Gui-arain/Flight-Controller/docs/README.md

<!--
This project follows atomic documentation.
Each subsystem is documented independently.
All configs are stored in YAML.
This directory is optimized for LLMs.
-->

# Flight Controller Documentation

This documentation describes the hardware, power, MCU, sensor suite, and communication interfaces.
