Gui-arain/Flight-Controller/docs/hardware/stm32-subsystem/imgs/analog-power-filter.png

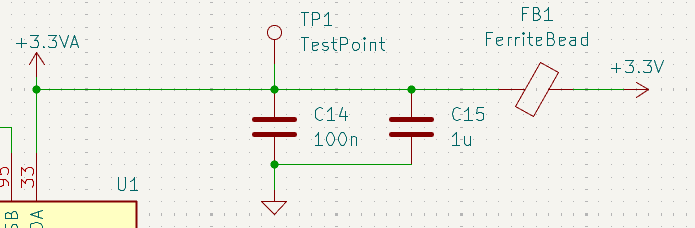
docs/hardware/stm32-subsystem/imgs/analog-power-filter.png
