Gui-arain/Flight-Controller/docs/hardware/stm32-subsystem/imgs/vref-filter.png

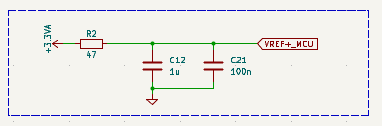
docs/hardware/stm32-subsystem/imgs/vref-filter.png
