Gui-arain/Flight-Controller/exports/imgs/Capture d’écran 2026-05-28 à 21.54.42.png

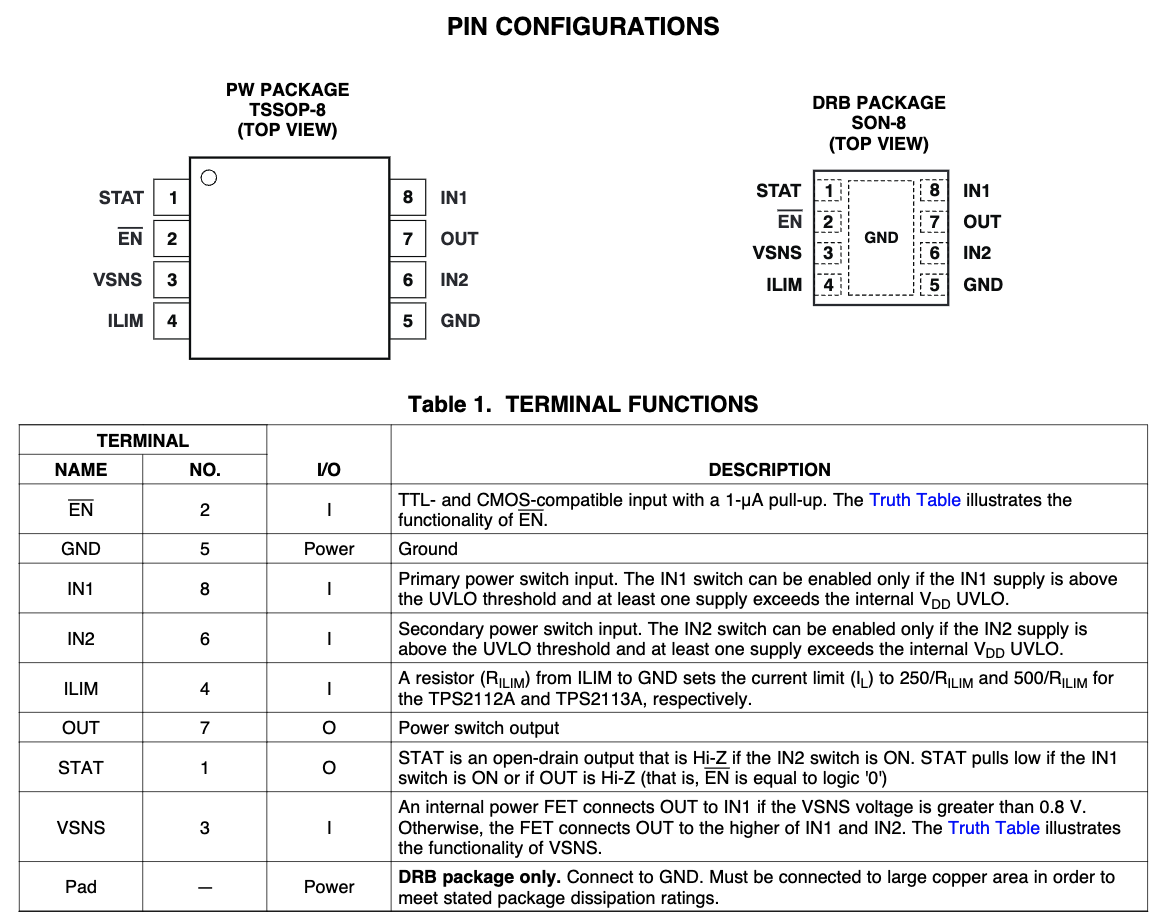
exports/imgs/Capture d’écran 2026-05-28 à 21.54.42.png
