Gui-arain/Flight-Controller/hardware/Component-Library.xlsx

Sheet: ICs
Category | Component | Description |  |  | Boards |  | Suppliers
 |  | Package | Datasheet | Comment | proto v1.0 | v2.0 | JLCPCB | DigiKey
SENSOR
IMU | ICM-42688-P |  | ..\resources\datasheets\IMU\ds-000347_icm-42688-p-datasheet.pdf | best noise / ODR 32kHz | yes | yes
 | BMI088 |  | ..\resources\datasheets\IMU\bst-bmi088-ds001.pdf | Best reliability max acc 24g | no | yes
 | ICM-40609-D |  |  | ODR 32kHz max 32g | no | yes
MAG | MMC5983MA |  | ..\resources\datasheets\MAG\MMC5983MADatasheetRevA.pdf | best heading | yes | yes
 | BMM350 |  | ..\resources\datasheets\MAG\bst-bmm350-ds001.pdf | reliable | no | ?
BAR | MS5611-01BA03 |  | ..\resources\datasheets\BAR\ENG_DS_MS5611-01BA03_B3.pdf |  | no | yes
 | BMP390 |  | ..\resources\datasheets\BAR\bst-bmp390-ds002.pdf |  | yes | yes
COMPUTING
MCU | STM32H743ZIT6 | LQFP-144 | ..\resources\datasheets\STM32\Datasheet\STM32H743xI-G.pdf |  | yes | no | STM32H743ZIT6 (https://jlcpcb.com/partdetail/STMicroelectronics-STM32H743ZIT6/C114408)
 | STM32H753 |  |  |  | yes | no
 | STM32H757 |  |  | dual core | yes | no
POWER
MUX | TPS2113A | 8-VDFN Exposed Pad (3x3) | ..\resources\datasheets\POWER\TPS2113a.pdf | 5V Mux 2A max | yes | no |  | DigiJey-TPS2113A (https://www.digikey.com.au/en/products/detail/texas-instruments/TPS2113ADRBR/2353703)
BUCK | TPS62130ARGTR | 16-VFQFN Exposed Pad (https://www.digikey.com.au/en/products/filter/power-management-pmic/voltage-regulators-dc-dc-switching-regulators/16-vfqfn-exposed-pad/739) | ..\resources\datasheets\POWER\TPS62130.pdf |  | yes | no |  | DigiKey-TPS62130 (https://www.digikey.com.au/en/products/detail/texas-instruments/TPS62130ARGTR/4307640)
TRANSCEIVER
CAN | MCP2562FD-E/SN | 8-SOIC (0.154", 3.90mm Width) | ..\resources\datasheets\CAN\MCP2561-2FD-datasheet.pdf | convert CAN TX/RX to H/L | yes |  | JLCPCB-MCP2562FD (https://jlcpcb.com/partdetail/MicrochipTech-MCP2562FD_ESN/C124016) | DigiKey-MCP2562FD (https://www.digikey.com.au/en/products/detail/microchip-technology/MCP2562FD-E-SN/4842808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)
 | MCP2562FDT-E/MF | 8-VDFN Exposed Pad |  |  | no |  |  | DijiKey-MPC2562FDF (https://www.digikey.com.au/en/products/detail/microchip-technology/MCP2562FDT-E-MF/4860104)

Sheet: Standard components
Category | Component | Description |  |  | Boards |  | Suppliers
 |  | Package | Datasheet | Comment | proto v1.0 | v2.0 | JLCPCB | DigiKey
LED | 19-337C/RSBHGHC-A88/4T | 0606 (1616 Metric) | ..\resources\datasheets\LED\Everlight 19-337C.pdf | RGB LED | yes | yes |  | DigiKey-19-337C (https://www.digikey.com.au/en/products/detail/everlight-electronics-co-ltd/19-337C-RSBHGHC-A88-4T/10059590)
 | LTST-C150EKT | 1206 (3216 Metric) | ..\resources\datasheets\LED\LTST-C150EKT.pdf | Red LED | yes | no |  | DigiKey-LTST-C150EKT (https://www.digikey.com.au/en/products/detail/liteon/LTST-C150EKT/269215)
 | LTST-C150GKT | 1206 (3216 Metric) | ..\resources\datasheets\LED\LTST-C150GKT.pdf | Green LED | yes | no | JLCPCB-LTST-C150EKT (https://jlcpcb.com/partdetail/LiteOn-LTSTC150GKT/C125084) | DigiKey-LTST-C150GKT (https://www.digikey.com.au/en/products/detail/liteon/LTST-C150GKT/269216)
 | LTST-C191KGKT | 0603 (1608 Metric) | ..\resources\datasheets\LED\LTST-C191KGKT.PDF | Green LED | no | yes |  | DigiKey-LTST-C161KGKT (https://www.digikey.com.au/en/products/detail/liteon/LTST-C191KGKT/386835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)
CRYSTAL | TSX-3225 16.0000MF18X-AC3 | 4-SMD (3.2x2.5) | ..\resources\datasheets\CRYSTAL\TSX-3225_en.pdf | 16MHz 9pF 60Ohms | yes |  | JLCPCB-TSX-3225 (https://jlcpcb.com/partdetail/2078519-TSX_3225_16_0000MF18XAC3/C1986974) | DigiKey-TSX3225 (https://www.digikey.com.au/en/products/detail/epson/TSX-3225-16-0000MF18X-AC3/1825445)
SWITCH | PCM12SMTR |  | ..\resources\datasheets\SWITCH\C221841.pdf | 6V | yes |  | JLCPCB-PCM12SMTR (https://jlcpcb.com/partdetail/CK-PCM12SMTR/C221841) | DigiKey-PCM12SMTR (https://www.digikey.com.au/en/products/detail/c-k/PCM12SMTR/1640112)
 | CUS-12TB |  | ..\resources\datasheets\SWITCH\CUS-12TB.pdf | 4V | no |  | JLCPCB-CUS-12TB (https://jlcpcb.com/partdetail/Nidec-CUS12TB/C2921739) | DigiKey-CUS-12TB (https://www.digikey.com.au/en/products/detail/nidec-components-corporation/CUS-12TB/1124222)
CAP | CL05B104KO5NNNC | 0402 (1005 Metric) |  | 100nF MLCC | yes |  | JLCPCB-MLCC100nF (https://jlcpcb.com/partdetail/1877-CL05B104KO5NNNC/C1525)
 |  | 0603 |  | MLCC | no
 |  | 0805 |  | MLCC | no
 |  | 0402 |  | Tantalum | no
 |  | 0603 |  | Tantalum | no
 |  | 0805 |  | Tantalum | no
ESD | TPD4E05U06DQAR | 10-UFDFN (2.5x1) | ..\resources\datasheets\ESD\tpd4e05u06.pdf | TVS DIODE 5.5VWM 14VC 10USON | yes |  | JLCPCB-TPD4E05 (https://jlcpcb.com/partdetail/TexasInstruments-TPD4E05U06DQAR/C138714) | DigiKey-TPD4E05 (https://www.digikey.com/en/products/detail/texas-instruments/TPD4E05U06DQAR/3996774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)
 | TSD05DYFR | SC-76, SOD-323 | ..\resources\datasheets\ESD\tsd05.pdf | TVS DIODE 5.5VWM 9VC SOD-323 | yes |  | JLCPCB-TSD05 (https://jlcpcb.com/partdetail/TexasInstruments-TSD05DYFR/C22396185) | DigiKey-TSD05 (https://www.digikey.com/en/products/detail/texas-instruments/TSD05DYFR/21298352)
FUSE | MF-MSMF050-2 | 1812 (4532 Metric), Concave | ..\resources\datasheets\FUSE\mf-msmf.pdf | Polymeric PTC Resettable Fuse 15V 500 mA | yes |  | JLCPCB-MF-MSMF050 (https://jlcpcb.com/partdetail/BOURNS-MF_MSMF0502/C17313) | DigiKey-MF-MSMF050 (https://www.digikey.com.au/en/products/detail/bourns-inc/MF-MSMF050-2/662816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)
MOSFET | 2N7002 | SOT-23-3 (TO-236) | ..\resources\datasheets\MOSFET\Diotec-2n7002.pdf | MOSFET N-CH 60V 280MA | no |  |  | DigiKey-2N7002 (https://www.digikey.com.au/en/products/detail/diotec-semiconductor/2N7002/13163336)
 | AO3400A | 3-SMD, SOT-23-3 Variant (https://www.digikey.com.au/en/products/filter/transistors/fets-mosfets/single-fets-mosfets/3-smd-sot-23-3-variant/278) | ..\resources\datasheets\MOSFET\AO3400A_ds.pdf | N-Channel 30 V 5.7A (Ta) 1.4W (Ta | yes |  | JLCPCB-AO3400A (https://jlcpcb.com/partdetail/Alpha_OmegaSemicon-AO3400A/C20917) | DigiKey-AO3400A (https://www.digikey.com.au/en/products/detail/alpha-omega-semiconductor-inc/AO3400A/1855772)

Sheet: Interfaces
Category | Component | Description |  |  | Boards |  | Suppliers
 |  | Package | Datasheet | Comment | proto v1.0 | v2.0 | JLCPCB | DigiKey
MEM | MEM2061 |  | ..\resources\datasheets\SD_CARD\mem2061-spec.pdf | micro SD card socket | yes | yes |  | DigiKey-MEM2061 (https://www.digikey.com.au/en/products/detail/gct/MEM2061-01-188-00-A/9859612)
USB-C | USB4105 |  | ..\resources\datasheets\USB-C\usb4105-spec.pdf |  | yes | yes
CONNECTOR | SM04B-GHS-TB |  | ..\resources\datasheets\CONNECTOR\GH1.25-datasheet.pdf | GH1,25 4 pins | yes |  |  | DigiKey-SM04B-GHS (https://www.digikey.com.au/en/products/detail/jst-sales-america-inc/SM04B-GHS-TB/807788)
 | SM03B-GHS-TB |  | ..\resources\datasheets\CONNECTOR\GH1.25-datasheet.pdf | GH1,26 3pins | yes |  |  | DigiKey-SM03B-GHS (https://www.digikey.com.au/en/products/detail/jst-sales-america-inc/SM03B-GHS-TB/807787)
 | SM06B-GHS-TB |  | ..\resources\datasheets\CONNECTOR\GH1.25-datasheet.pdf | GH1,26 6pins | yes |  |  | DigiKey-SM6B-GHS (https://www.digikey.com.au/en/products/detail/jst-sales-america-inc/SM06B-GHS-TB/807790)
 | FTSH-105-01-F-DV-K |  |  | 10 pin 1,27 for Cortex-M Debug | yes |  | JLCPCB-FTSH-105 (https://jlcpcb.com/partdetail/Samtec-FTSH_105_01_L_DVK/C5155080) | DigiKey-FTSH-105 (https://www.digikey.com.au/en/products/detail/samtec-inc/FTSH-105-01-F-DV-K/2649974)
