Gui-arain/Flight-Controller/hardware/cad-layout/19-337C/19-337C_RSBHGHC-A88_4T.STEP

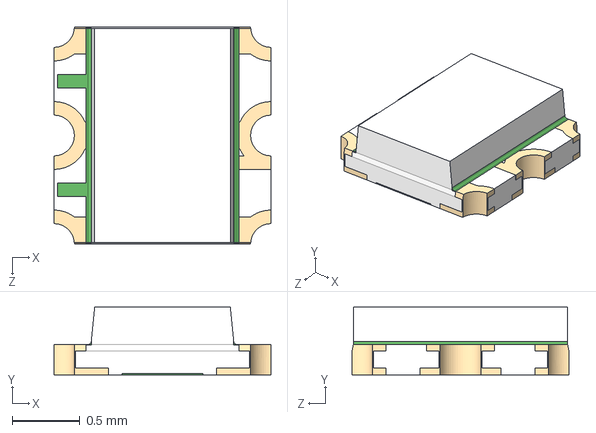
[picture p5: CAD file, 2025-11-23]
hardware/cad-layout/19-337C/19-337C_RSBHGHC-A88_4T.STEP
1.60 x 0.5 x 1.60 mm
