Gui-arain/Flight-Controller/hardware/cad-layout/BMP390/10LGA_2X2X0p75_BOS.step

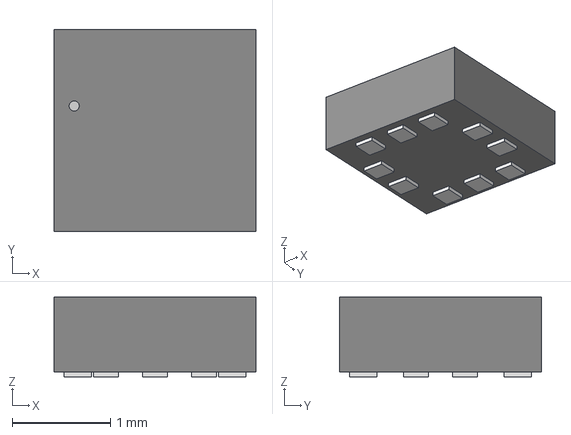
[picture p6: CAD file, 2025-11-23]
hardware/cad-layout/BMP390/10LGA_2X2X0p75_BOS.step
2.06 x 2.06 x 0.815 mm
