Gui-arain/Flight-Controller/hardware/cad-layout/FTSH-105-01-F-DV-K/FTSH-105-01-F-DV-K.stp

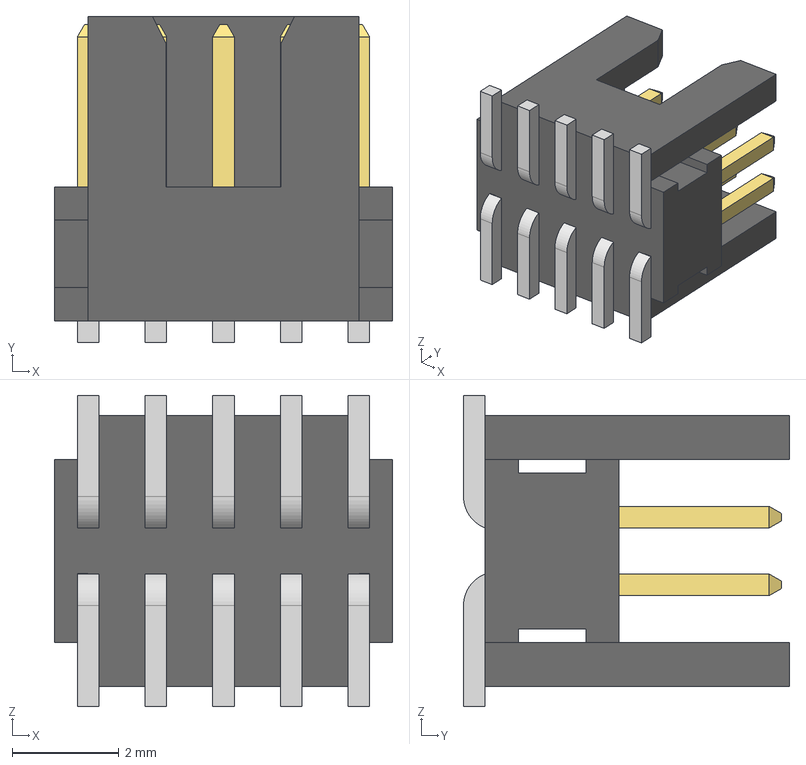
[picture p7: CAD file, 2025-11-23]
hardware/cad-layout/FTSH-105-01-F-DV-K/FTSH-105-01-F-DV-K.stp
6.35 x 6.12 x 5.84 mm
FTSH-105-01-F-DV-K_body
FTSH-105-01-F-DV-K_pins1
FTSH-105-01-F-DV-K_pins2
