Gui-arain/Flight-Controller/hardware/cad-layout/ICM-42688-P/LGA14_2P5X3X0P91_TDK.step

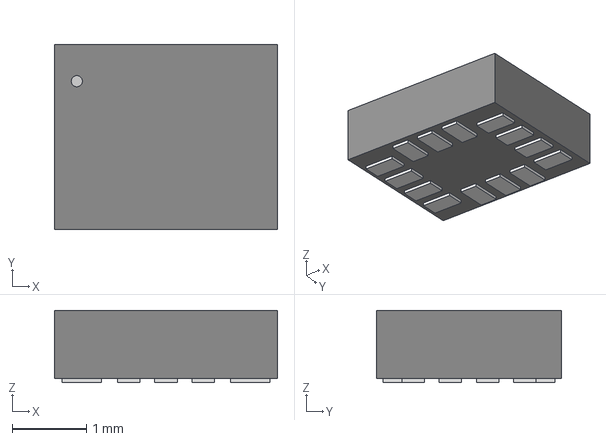
[picture p8: CAD file, 2025-11-23]
hardware/cad-layout/ICM-42688-P/LGA14_2P5X3X0P91_TDK.step
3.00 x 2.49 x 0.968 mm
