Gui-arain/Flight-Controller/hardware/cad-layout/LTST-C150GKT/LTST-C150GKT.STEP

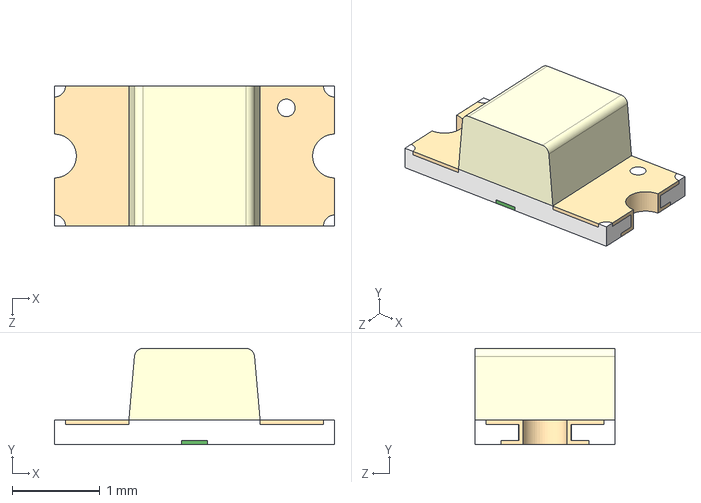
[picture p9: CAD file, 2025-11-23]
hardware/cad-layout/LTST-C150GKT/LTST-C150GKT.STEP
3.20 x 1.10 x 1.60 mm
