Gui-arain/Flight-Controller/hardware/cad-layout/MCP2562FD-E-SN/SOIC8-N_MC_MCH.step

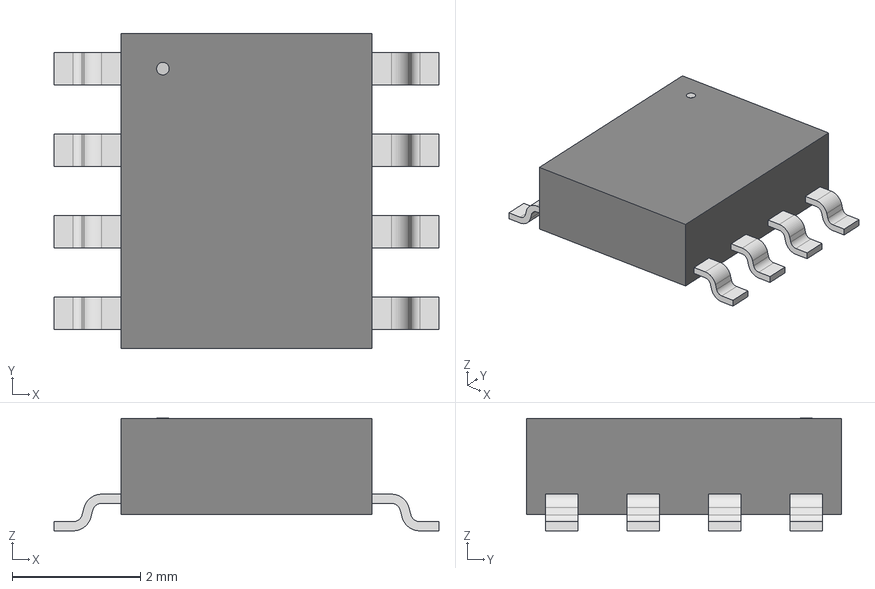
[picture p10: CAD file, 2025-11-23]
hardware/cad-layout/MCP2562FD-E-SN/SOIC8-N_MC_MCH.step
5.99 x 4.90 x 1.75 mm
