Gui-arain/Flight-Controller/hardware/cad-layout/MMC5983MA/MMC5983MA_MEM.step

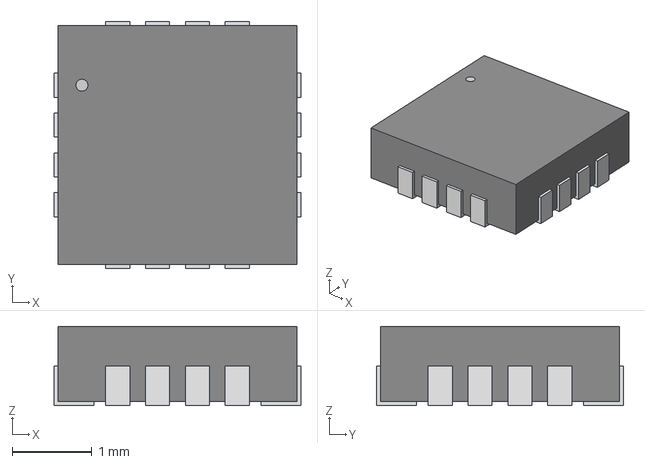
[picture p11: CAD file, 2025-11-23]
hardware/cad-layout/MMC5983MA/MMC5983MA_MEM.step
3.10 x 3.10 x 0.993 mm
