Gui-arain/Flight-Controller/hardware/cad-layout/SM03B-GHS-TB/SM03B-GHS-TB.STEP

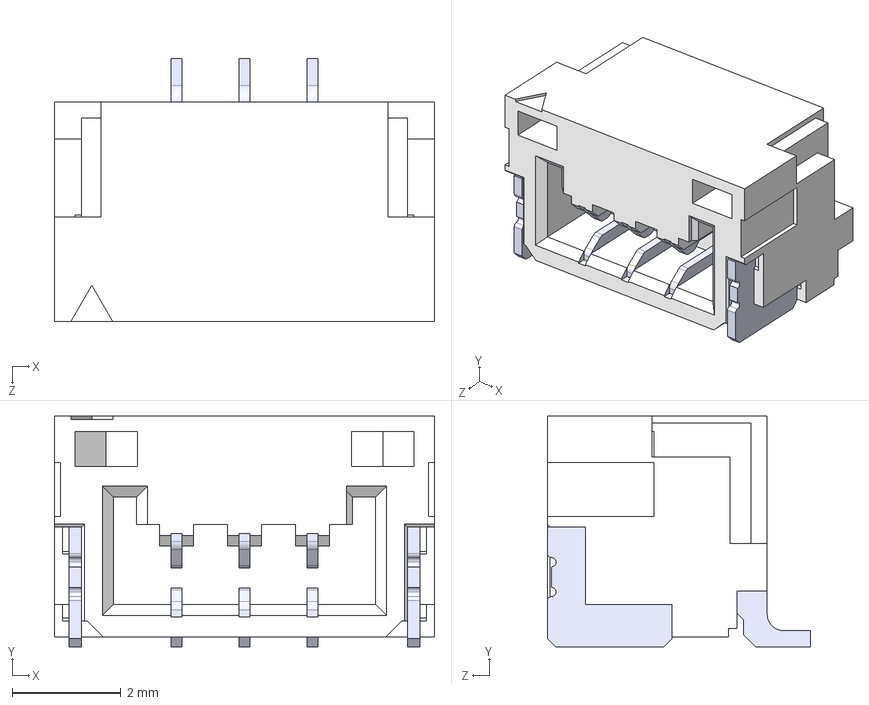
[picture p12: CAD file, 2025-11-23]
hardware/cad-layout/SM03B-GHS-TB/SM03B-GHS-TB.STEP
7.00 x 4.25 x 4.85 mm
SMxB-GHS-TB_03
pin x 3
