Gui-arain/Flight-Controller/hardware/cad-layout/SM06B-GHS-TB/SM06B-GHS-TB.STEP

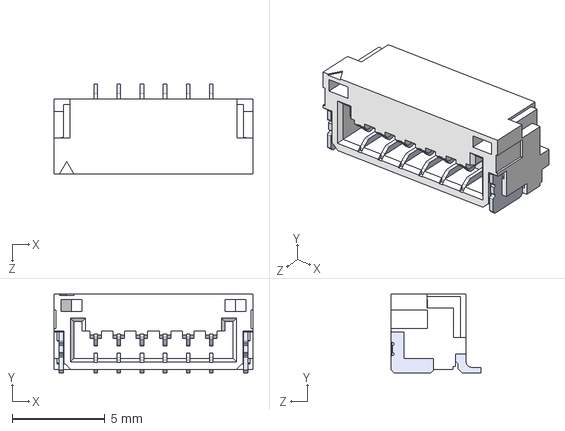
[picture p13: CAD file, 2025-11-23]
hardware/cad-layout/SM06B-GHS-TB/SM06B-GHS-TB.STEP
10.8 x 4.25 x 4.85 mm
SMxB-GHS-TB_06
pin x 6
