Gui-arain/Flight-Controller/hardware/cad-layout/STM32H743ZIT6/LQFP144-20x20mm.step

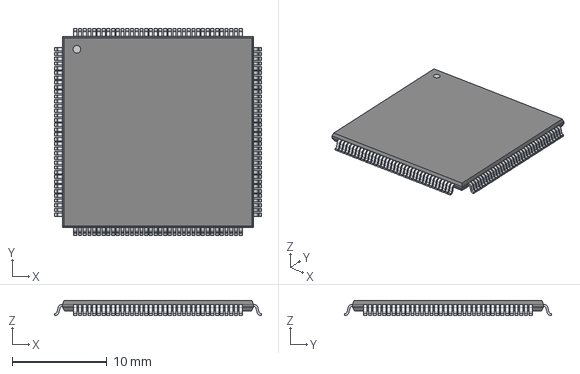
[picture p14: CAD file, 2025-11-23]
hardware/cad-layout/STM32H743ZIT6/LQFP144-20x20mm.step
21.9 x 21.9 x 1.60 mm
