Gui-arain/Flight-Controller/hardware/cad-layout/TPD4E05U06DQAR/DQA0010B.stp

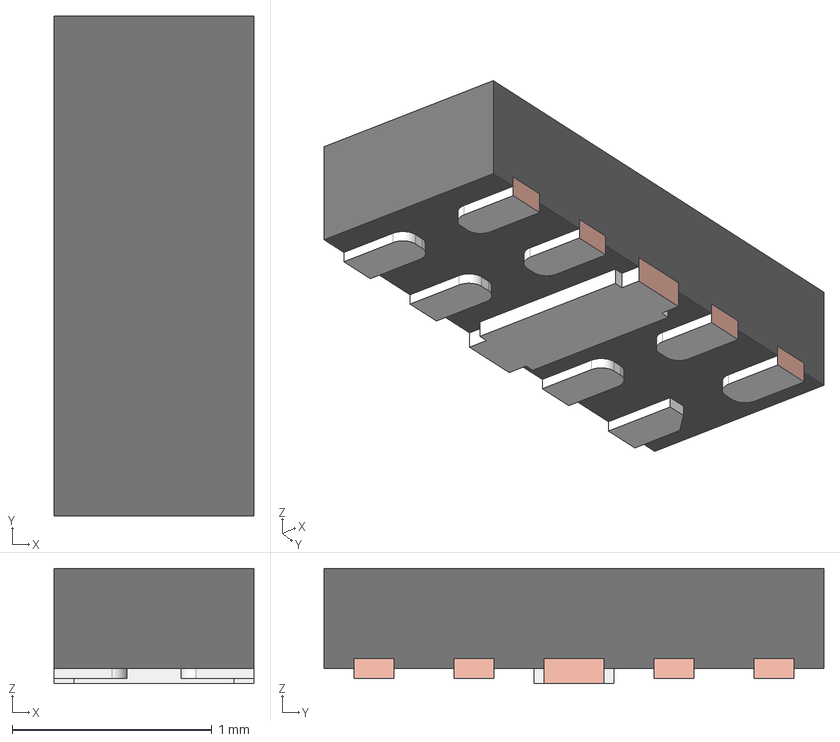
[picture p15: CAD file, 2025-11-23]
hardware/cad-layout/TPD4E05U06DQAR/DQA0010B.stp
1.00 x 2.50 x 0.577 mm
DQA0010B_BODY
DQA0010B_FRAME
DQA0010B_PIN1-ID
