Gui-arain/Flight-Controller/hardware/cad-layout/TPS2113A/DRB0008B.stp

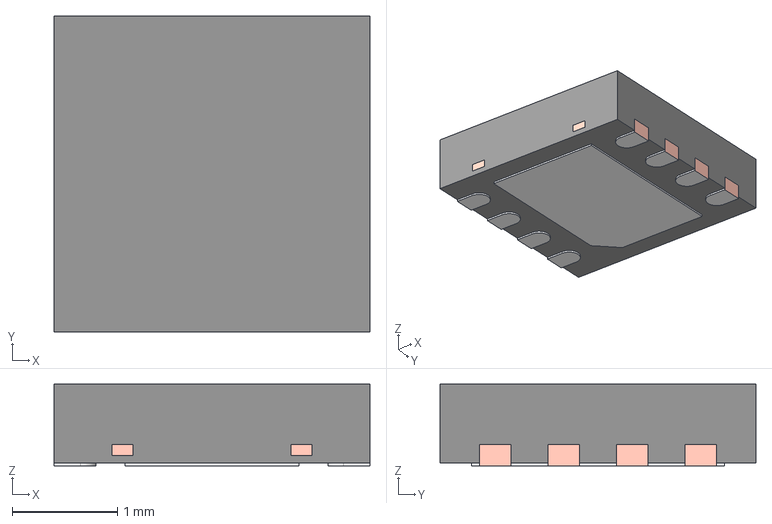
[picture p16: CAD file, 2025-11-23]
hardware/cad-layout/TPS2113A/DRB0008B.stp
3.00 x 3.00 x 0.775 mm
BODY-SON
FRAME-DRB0008B
