Gui-arain/Flight-Controller/hardware/cad-layout/TPS62130RGTR/RGT0016C.stp

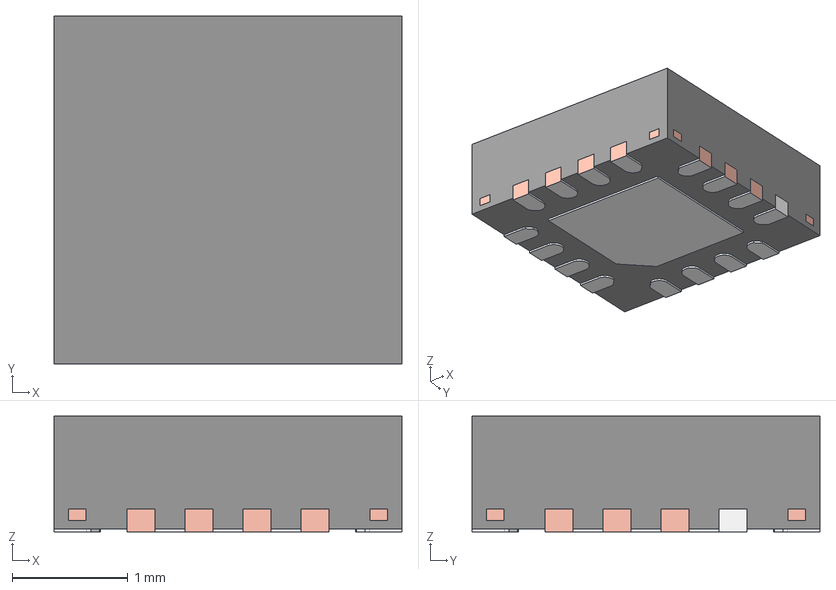
[picture p17: CAD file, 2025-11-23]
hardware/cad-layout/TPS62130RGTR/RGT0016C.stp
3.00 x 3.00 x 1.00 mm
BODY-QFN
FRAME-RGT0016C
PIN1-ID
