Gui-arain/Flight-Controller/hardware/cad-layout/TSD05DYFR/DYF0002A.stp

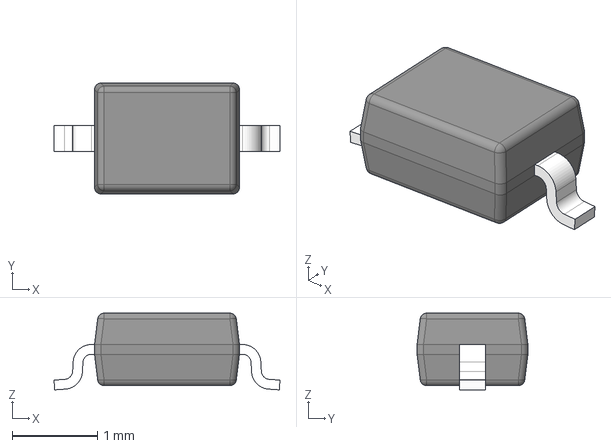
[picture p18: CAD file, 2025-11-23]
hardware/cad-layout/TSD05DYFR/DYF0002A.stp
2.65 x 1.30 x 0.9 mm
BODY-SOT
LEAD-SOT x 2
