Gui-arain/Flight-Controller/hardware/cad-layout/TSX_3225_16M/TSX-3225_16.0000MF18X-AC3.step

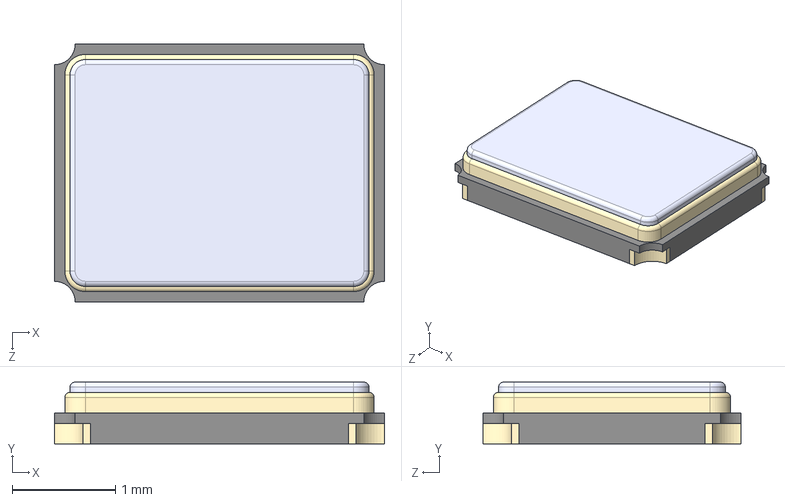
[picture p19: CAD file, 2025-11-23]
hardware/cad-layout/TSX_3225_16M/TSX-3225_16.0000MF18X-AC3.step
3.20 x 0.6 x 2.50 mm
