Gui-arain/Flight-Controller/exports/version-history.md

# Version History

This file present the different versions of the board that have been designed. It also reports wich version has been manufactured and tested

## Current version information:

FC manufactured

- name : ***Shirley***
- descriptive name : **FC Dev Board**
- version number: **0.9.5**
- [Schematic exported](FC-Dev-Board-v0.9.5-Schem.pdf/FC-Dev-Board-v0.9.5-Schem.pdf)
- Manufactured : produced 
- Tested : ***In testing...***
    - ✅ STM32 checks
    - ✅ IMU
    - ✅ MAG
    -  ❌ BAR
    - ✅ PWR checks

## Past versions:
- v0.9:
Note: changed the barometer to BMP388 (stock issue)
- v0.8:
Note: changed the USB-C ESD protection
- v0.7:
[Schematic exported](FC-Dev-Board-v0.7-Schem.pdf)
; Note: Design posted and reviewed([reddit](https://www.reddit.com/r/PrintedCircuitBoard/comments/1qci8jg/review_request_drone_flight_controller_with/))
- v0.5:
[Schematic exported](past-versions/FC_Schem_v0.5.pdf)
- v0.3:
[Schematic exported](past-versions/FC_Schem_v0.3.pdf)
; Note : Use the ICM-42688-P IMU

---
