Gui-arain/Flight-Controller/exports/FC-Dev-Board-v0.9.5-Schem.pdf/FC-Dev-Board-v0.9.5-Schem.pdf

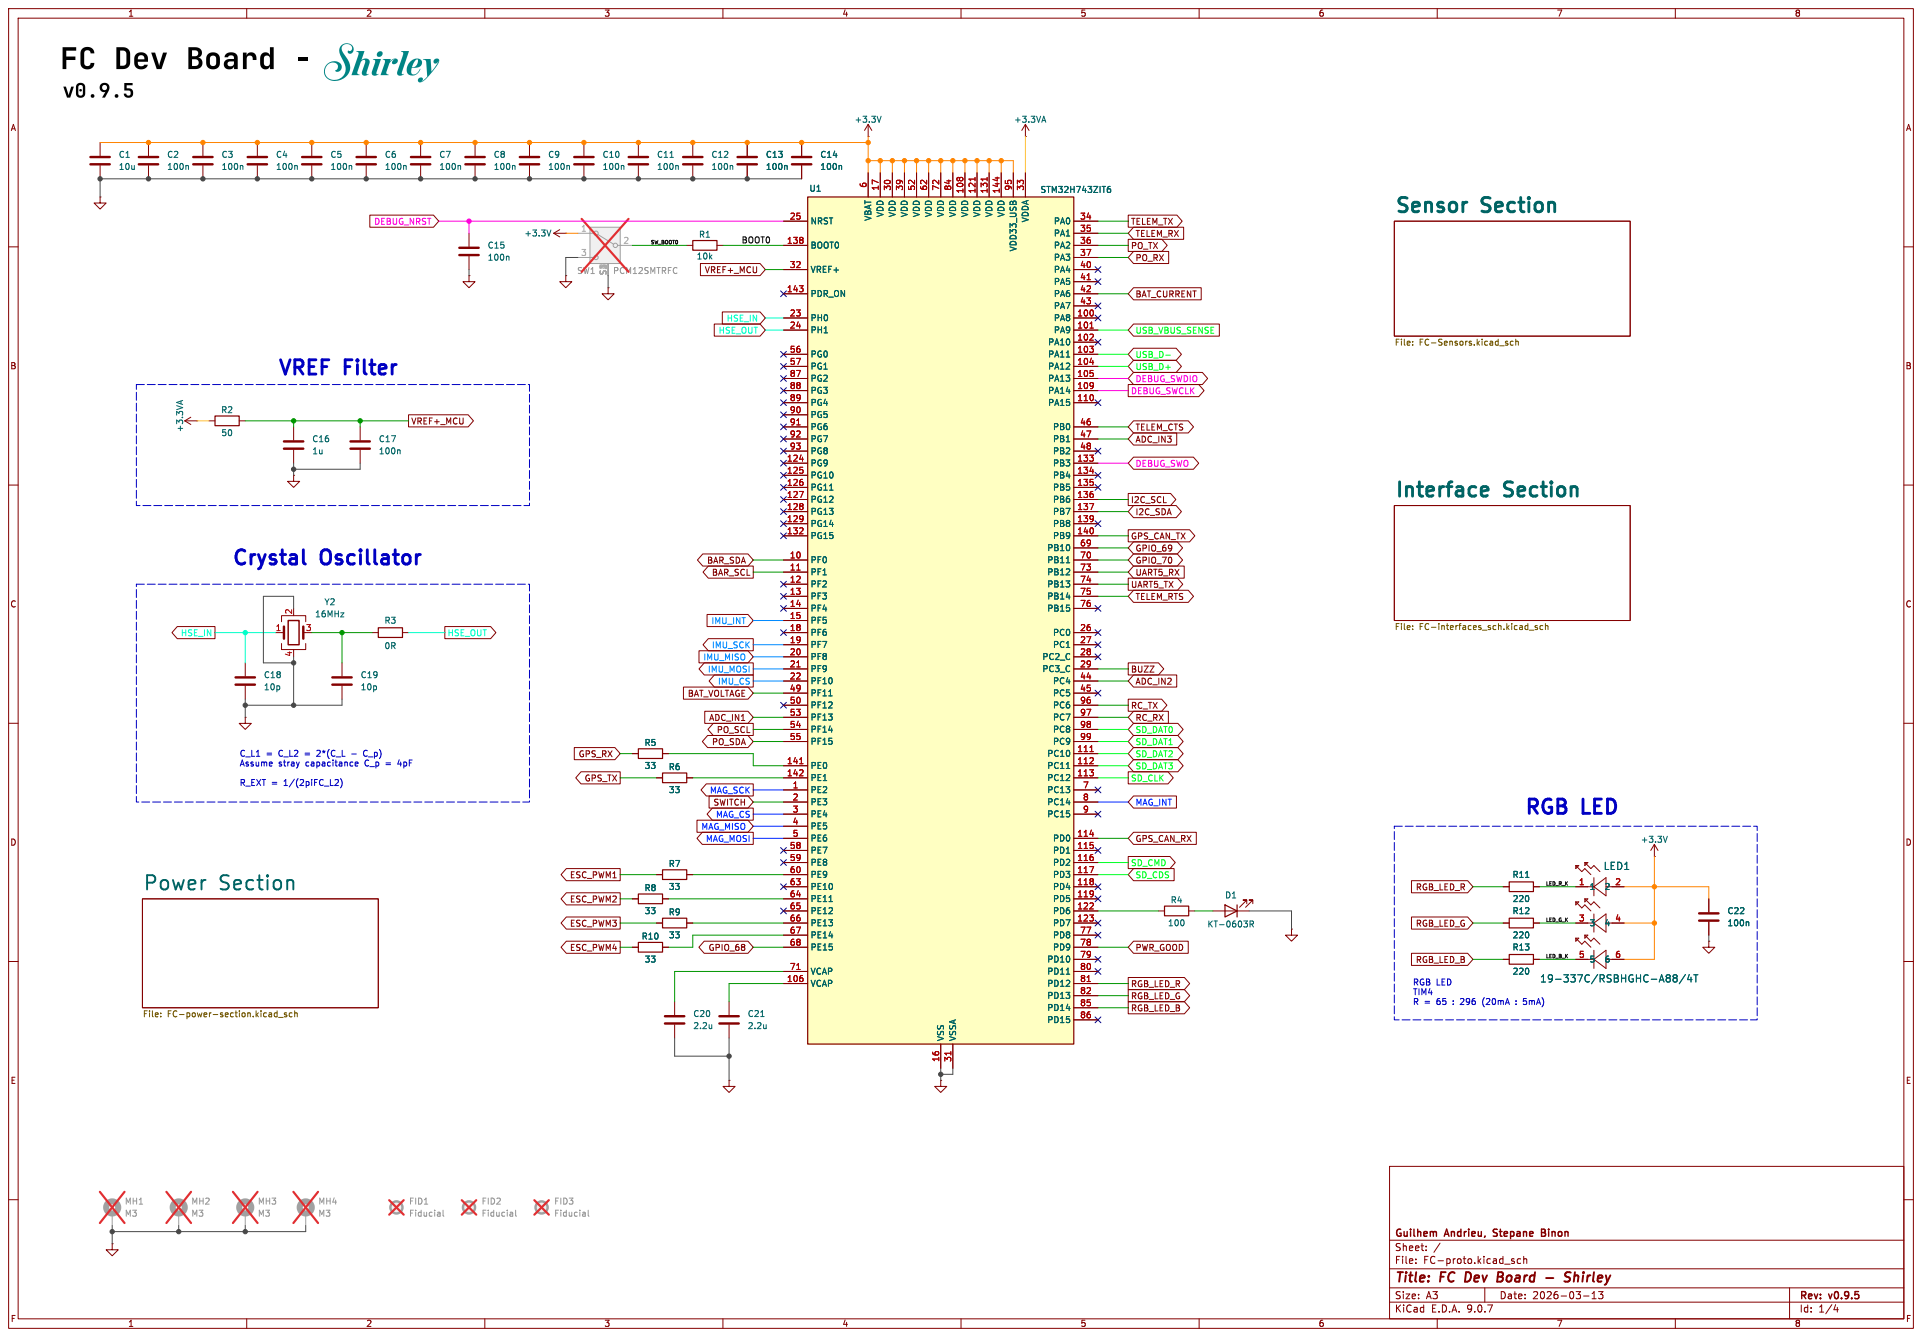
[picture p21: page 1]

File: FC-power-section.kicad_sch

Id: 1/4 Title: FC Dev Board - Shirley

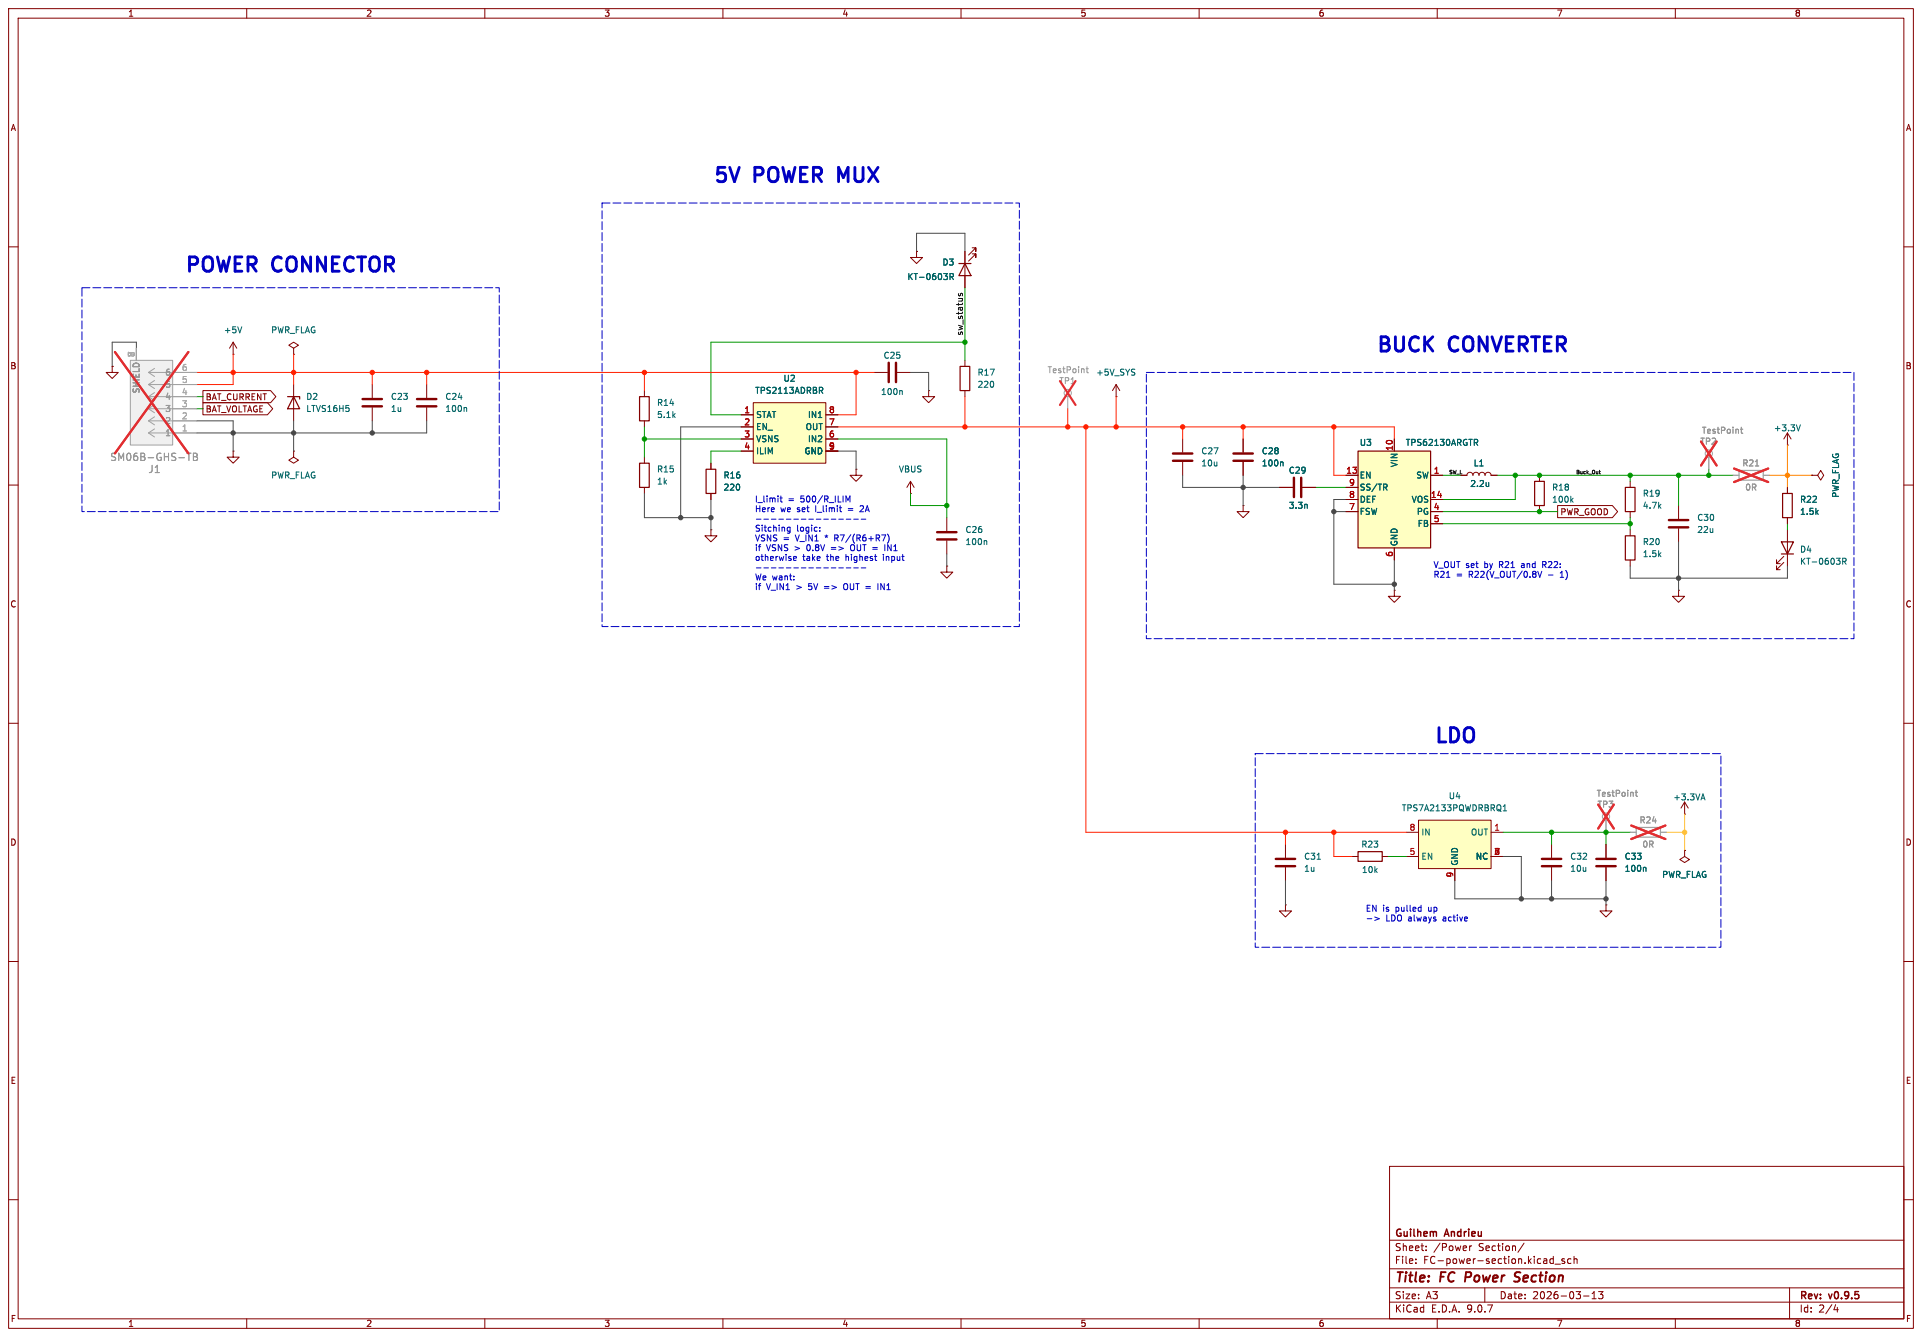
[picture p22: page 2]

6 SW 1 VOS 14 PG 4 FB 5 U3 TPS62130ARGTR

6 SW 1 VOS 14 PG 4 FB 5

EN is pulled up

Id: 2/4 Title: FC Power Section

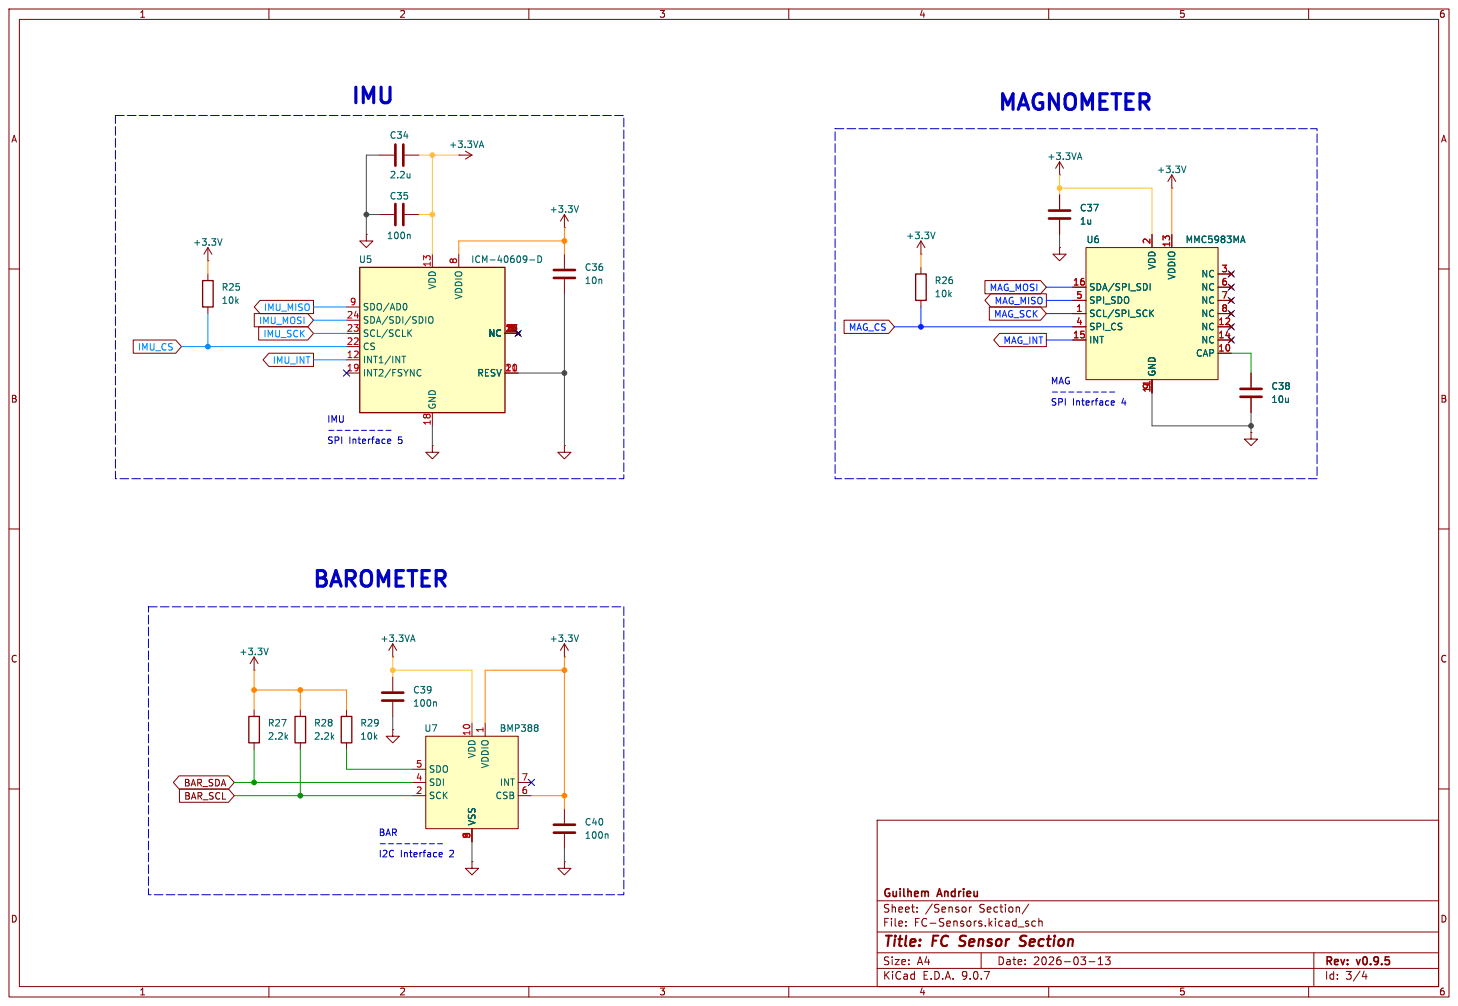
[picture p23: page 3]

2 GND 119 VDDIO 13 NC 3 NC 6 NC 7 NC 8 NC 12 CAP 10 NC 14 C37

2 GND 119 VDDIO 13 NC 3 NC 6 NC 7 NC 8 NC 12 CAP 10 NC 14 U6 MMC5983MA C38

Id: 3/4 Title: FC Sensor Section

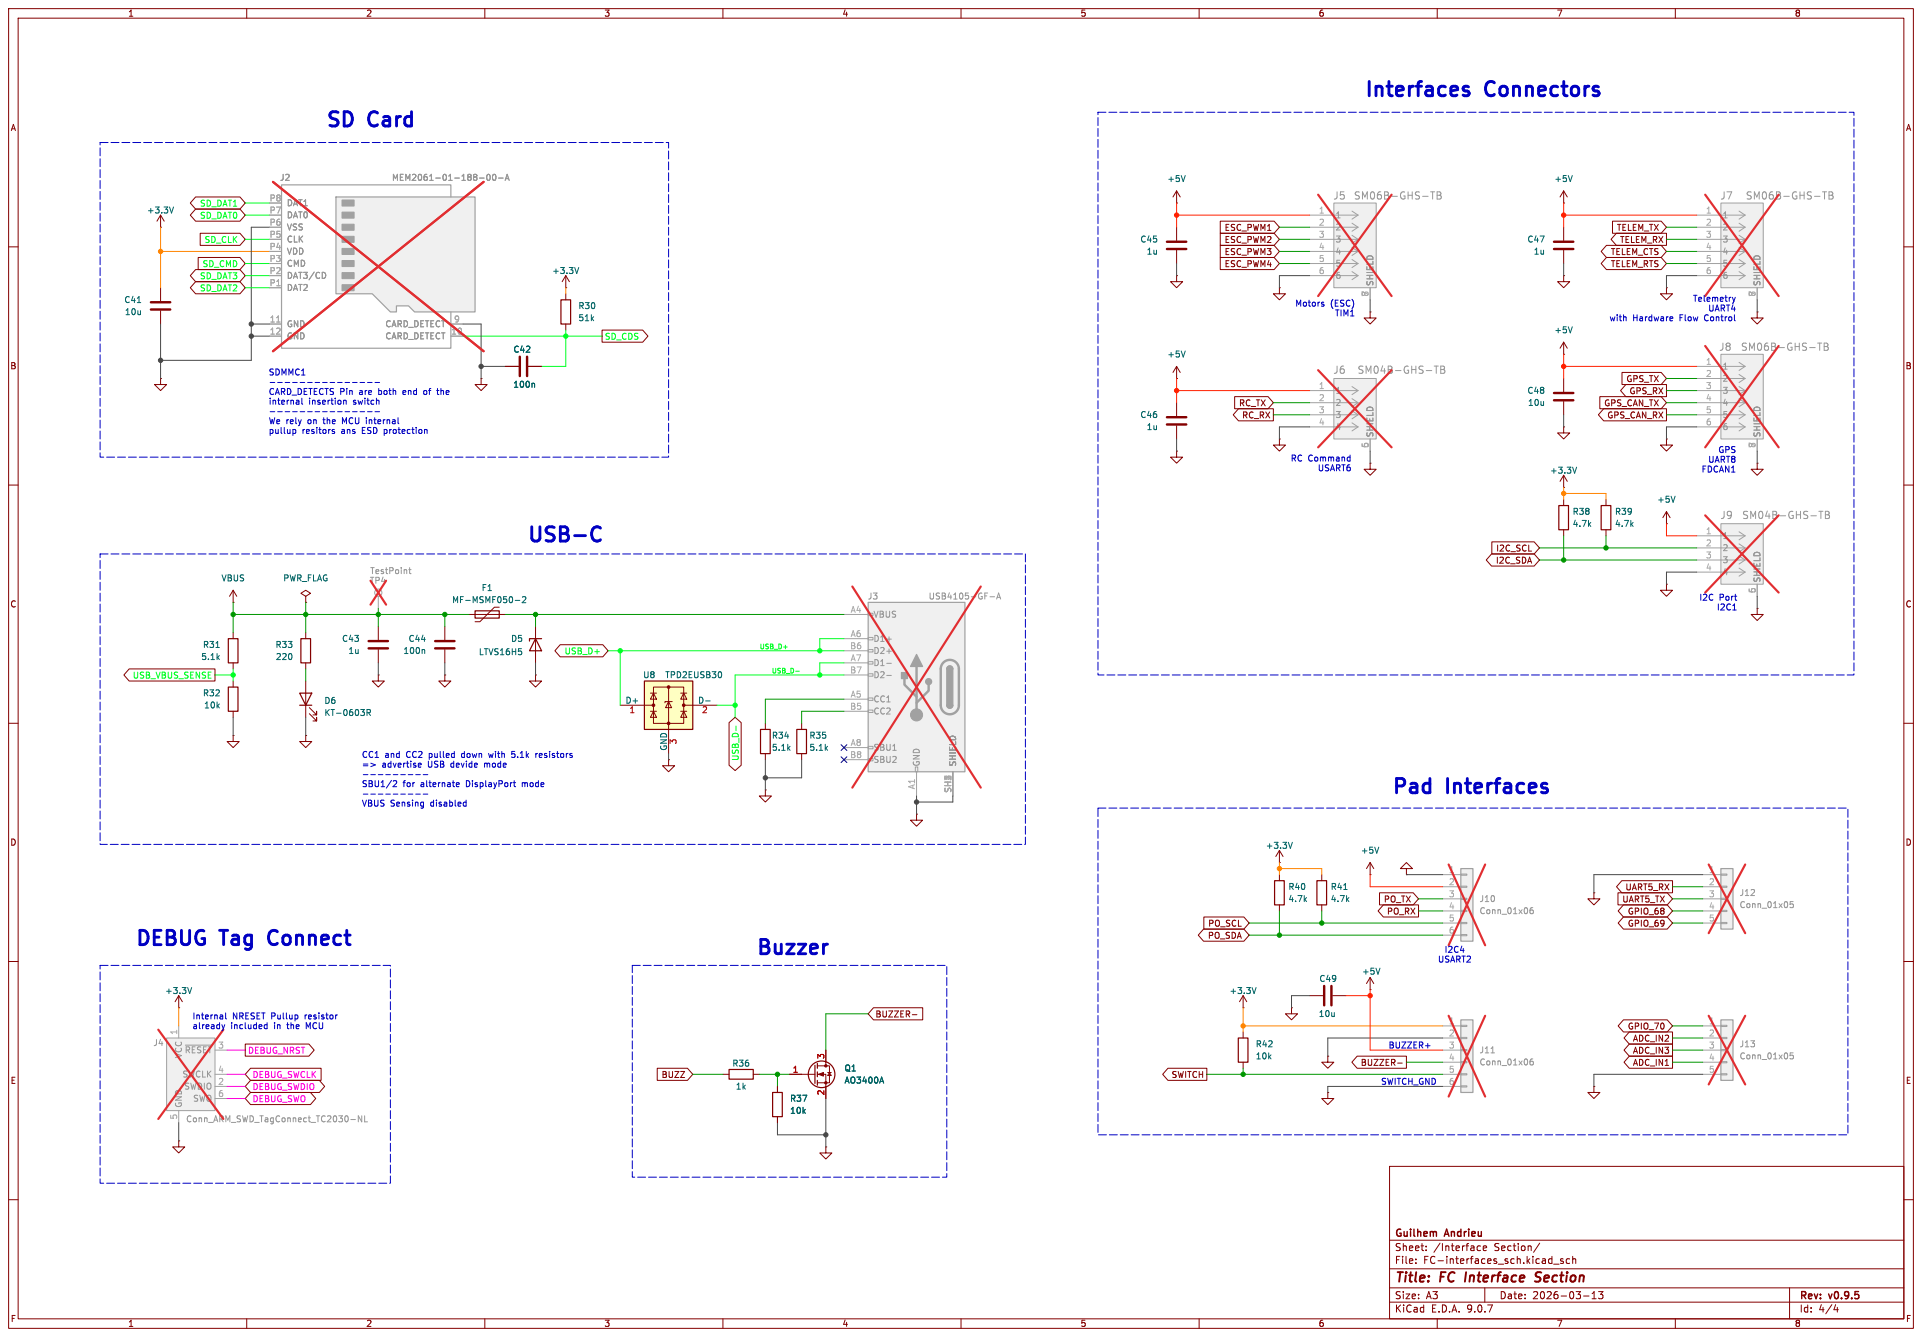
[picture p24: page 4]

SDMMC1
--------------- CARD_DETECTS Pin are both end of the

5 ~{RESET}3 SWCLK 4 SWDIO 2 SWO 6

Id: 4/4 Title: FC Interface Section
