Gui-arain/Flight-Controller/hardware/KiCad/FC_v1.0/FC-proto.kicad_pcb

## KiCad design hardware/KiCad/FC_v1.0/FC-proto.kicad_pcb (2026-07-22)

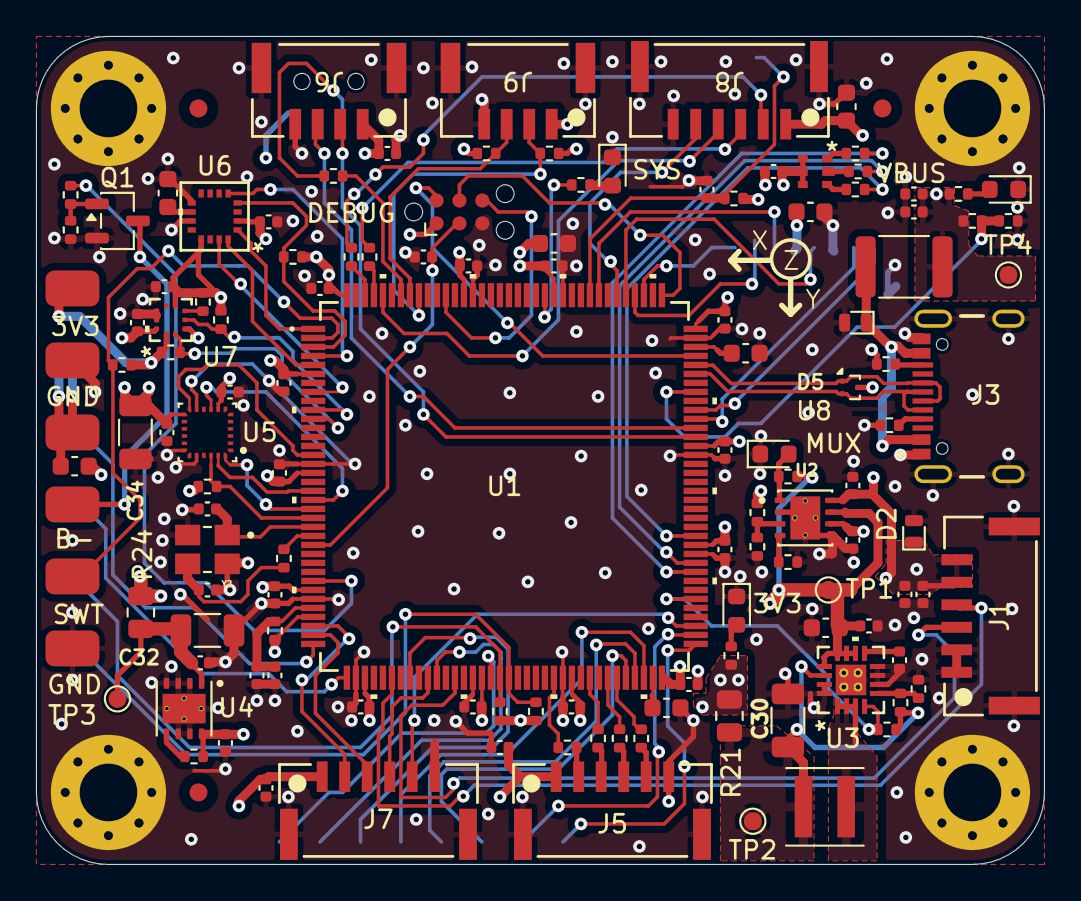
[picture p25: board FC-proto.kicad_pcb from above]

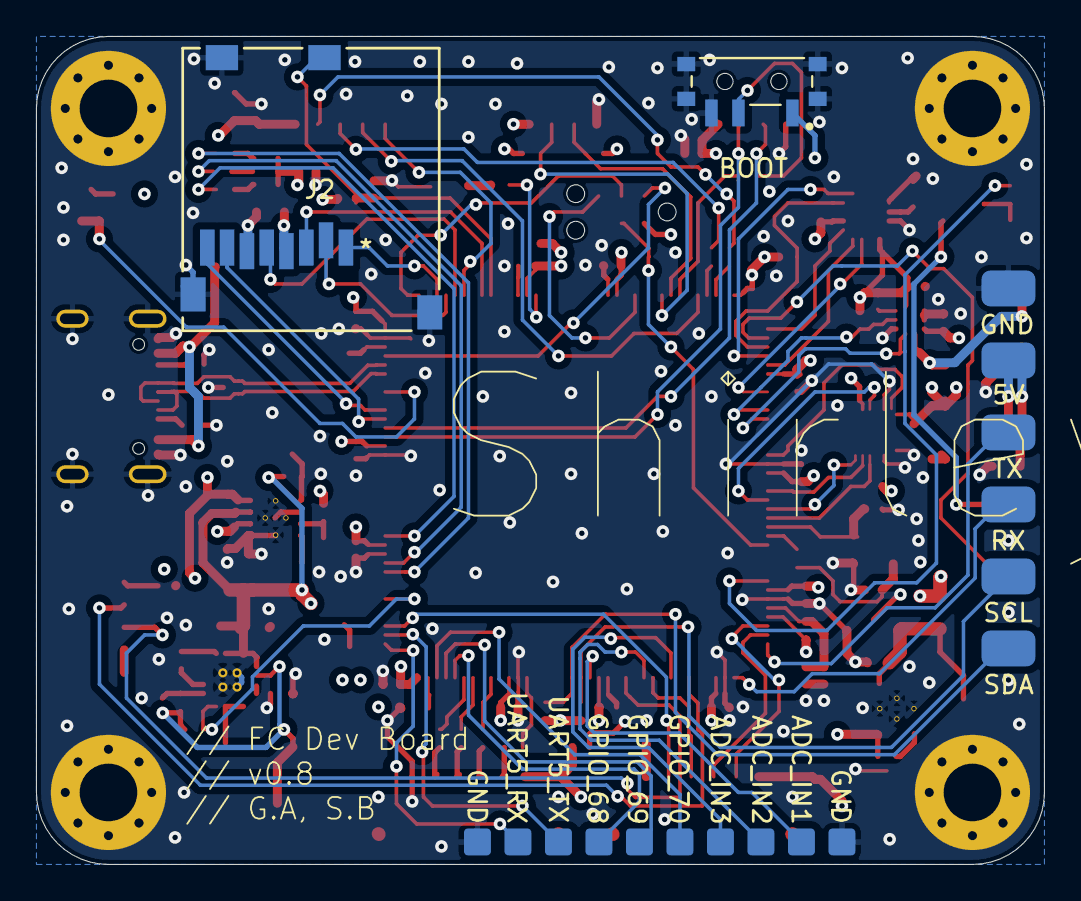
[picture p26: board FC-proto.kicad_pcb from below]

Board: 4 copper layers, 56.0 x 46.0 mm, 135 parts (5 on the bottom side), 105 nets.

Parts:
C1, C27, C38, C41, C48, C49: 10u; C_0603_1608Metric
C2, C3, C4, C5, C6, C7, C8, C9, C10, C11, C12, C13, C14, C15, C17, C22, C24, C25, C26, C28, C33, C35, C39, C40, C42, C44: 100n; C_0402_1005Metric
C16, C23, C31, C37, C43, C45, C46, C47: 1u; C_0402_1005Metric
C18, C19: 10p; C_0402_1005Metric
C20, C21: 2.2u; C_0603_1608Metric
C29: 3.3n; C_0402_1005Metric
C30: 22u; C_1206_3216Metric
C32: 10u; C_1206_3216Metric
C34: 2.2u; C_1206_3216Metric
C36: 10n; C_0402_1005Metric
D1: SYS_LED; LED_0603_1608Metric
D2, D5: LTVS16H5; DFN1610-2
D3: MUX_LED; LED_0603_1608Metric
D4: PWR_LED; LED_0603_1608Metric
D6: USB_LED; LED_0603_1608Metric
F1: MF-MSMF050-2; Fuse_1812_4532Metric
FID1, FID2, FID3: Fiducial; Fiducial_1mm_Mask2mm
J1, J5, J7, J8: SM06B-GHS-TB; CONN_SM06B-GHS-TB_JST
J2: MEM2061-01-188-00-A; MEM2061-01-188-00-A_GCT
J3: USB4105-GF-A; GCT_USB4105-GF-A
J4: Conn_ARM_SWD_TagConnect_TC2030-NL; Tag-Connect_TC2030-IDC-NL_2x03_P1.27mm_Vertical
J6, J9: SM04B-GHS-TB; CONN_SM04B-GHS-TB_JST
J10, J11: PAD_OUT; Pad_out_1x6
J12, J13: Conn_01x05; Pad_out_mini_1x5
L1: 2.2u; L_Coilcraft_XxL4020
LED1: 19-337C/RSBHGHC-A88/4T; SMD-B_19-337C_EVE
MH1, MH2, MH3, MH4: M3; MountingHole_3.2mm_M3_Pad_Via
Q1: AO3400A; SOT-23-3
R1, R23, R25, R26, R29, R37, R42: 10k; R_0402_1005Metric
R2: 47; R_0402_1005Metric
R3: 0R; R_0402_1005Metric
R4: 100; R_0402_1005Metric
R5, R6, R7, R8, R9, R10: 33; R_0402_1005Metric
R11, R12, R13: 220; R_0402_1005Metric
R14: 4.3k; R_0402_1005Metric
R15: 820; R_0402_1005Metric
R16, R17, R33: 250; R_0402_1005Metric
R18: 100k; R_0402_1005Metric
R19: 7.5k; R_0402_1005Metric
R20: 2.4k; R_0402_1005Metric
R21, R24: 0R; R_0805_2012Metric
R22: 1.5k; R_0402_1005Metric
R27, R28: 2.2k; R_0402_1005Metric
R30: 56k; R_0402_1005Metric
R31: 43k; R_0402_1005Metric
R32: 82k; R_0402_1005Metric
R34, R35: 5.1k; R_0402_1005Metric
R36: 1k; R_0402_1005Metric
R38, R39, R40, R41: 4.7k; R_0402_1005Metric
SW1: PCM12SMTRFC; SW_PCM12SMTR
TP1, TP2, TP3, TP4: TestPoint; TestPoint_Pad_D1.0mm
U1: STM32H743ZIT6
U2: TPS2113ADRBR
U3: TPS62130ARGTR
U4: TPS7A2133PQWDRBRQ1
U5: ICM-40609-D
U6: MMC5983MA
U7: BMP390
U8: TPD2EUSB30A; Texas_DRT-3
Y2: 16MHz; TSX-3225_16MHz

Connections:
+3.3V: C1.1, C2.1, C3.1, C4.1, C5.1, C6.1, C7.1, C8.1, C9.1, C10.1, C11.1, C12.1, C13.1, C14.1, C22.1, C36.1, C40.1, C41.1, J2.P4 (VDD), J4.1 (VCC), J11.1, LED1.2, LED1.4, LED1.6, R21.1, R22.2, R25.2, R26.2, R27.2, R28.2, R29.2, R30.2, R38.2, R39.2, R40.2, R41.2, R42.2, SW1.1 (A), U1.6 (VBAT), U1.17 (VDD), U1.30 (VDD), U1.39 (VDD), U1.52 (VDD), U1.62 (VDD), U1.72 (VDD), U1.84 (VDD), U1.95 (VDD33_USB), U1.108 (VDD), U1.121 (VDD), U1.131 (VDD), U1.144 (VDD), U5.8 (VDDIO), U6.13 (VDDIO), U7.1 (VDDIO), U7.6 (CSB)
+3.3VA: C34.2, C35.2, C37.1, C39.1, R2.1, R24.1, U1.33 (VDDA), U5.13 (VDD), U6.2 (VDD), U7.10 (VDD)
+5V: C23.1, C24.1, C25.1, C45.1, C46.1, C47.1, C48.1, C49.2, D2.1 (K), J1.5, J1.6, J5.1, J6.1, J7.1, J8.1, J9.1, J10.2, J11.3, R14.2, U2.8 (IN1)
+5V_SYS: C27.2, C28.2, C31.2, R17.1, R23.2, TP1.1, U2.7 (OUT), U3.10 (VIN), U3.11 (VIN), U3.12 (VIN), U3.13 (EN), U4.8 (IN)
/BOOT0: R1.2, U1.138 (BOOT0)
/LED_B_K: LED1.5, R13.2
/LED_G_K: LED1.3, R12.2
/LED_R_K: LED1.1, R11.2
/Power Section/Buck_Out: C30.2, L1.2, R18.2, R19.2, R21.2, TP2.1, U3.14 (VOS)
/Power Section/SW_L: L1.1, U3.1 (SW), U3.2 (SW), U3.3 (SW)
/Power Section/sw_status: D3.2 (A), R17.2, U2.1 (STAT)
/SW_BOOT0: R1.1, SW1.2 (B)
ADC_IN1: J13.4, U1.53 (PF13)
ADC_IN2: J13.2, U1.44 (PC4)
ADC_IN3: J13.3, U1.47 (PB1)
BAR_SCL: R28.1, U1.11 (PF1), U7.2 (SCK)
BAR_SDA: R27.1, U1.10 (PF0), U7.4 (SDI)
BAT_CURRENT: J1.4, U1.42 (PA6)
BAT_VOLTAGE: J1.3, U1.49 (PF11)
BUZZ: R36.2, U1.29 (PC3_C)
BUZZER-: J11.4, Q1.3 (D)
DEBUG_NRST: C15.1, J4.3 (~RESET), U1.25 (NRST)
DEBUG_SWCLK: J4.4 (SWCLK), U1.109 (PA14)
DEBUG_SWDIO: J4.2 (SWDIO), U1.105 (PA13)
DEBUG_SWO: J4.6 (SWO), U1.133 (PB3)
ESC_PWM1: J5.2, R7.1
ESC_PWM2: J5.3, R8.1
ESC_PWM3: J5.4, R9.1
ESC_PWM4: J5.5, R10.1
GND: C1.2, C2.2, C3.2, C4.2, C5.2, C6.2, C7.2, C8.2, C9.2, C10.2, C11.2, C12.2, C13.2, C14.2, C15.2, C16.2, C17.2, C18.2, C19.2, C20.2, C21.2, C22.2, C23.2, C24.2, C25.2, C26.1, C27.1, C28.1, C29.2, C30.1, C31.1, C32.1, C33.1, C34.1, C35.1, C36.2, C37.2, C38.2, C39.2, C40.2, C41.2, C42.1, C43.2, C44.2, C45.2, C46.2, C47.2, C48.2, C49.1, D1.1 (K), D2.2 (A), D3.1 (K), D4.1 (K), D5.2 (A), D6.1 (K), J1.1, J1.2, J1.7 (SHIELD), J1.8 (SHIELD), J2.9 (CARD_DETECT), J2.11 (GND), J2.12 (GND), J2.P6 (VSS), J3.A1 (GND), J3.B1 (GND), J3.SH1 (SHIELD), J3.SH2 (SHIELD), J3.SH3 (SHIELD), J3.SH4 (SHIELD), J4.5 (GND), J5.6, J5.7 (SHIELD), J5.8 (SHIELD), J6.4, J6.5 (SHIELD), J6.6 (SHIELD), J7.6, J7.7 (SHIELD), J7.8 (SHIELD), J8.6, J8.7 (SHIELD), J8.8 (SHIELD), J9.4, J9.5 (SHIELD), J9.6 (SHIELD), J10.1, J11.2, J11.6, J12.1, J13.5, MH1.1, MH2.1, MH3.1, MH4.1, Q1.2 (S), R15.1, R16.1, R20.1, R32.1, R34.1, R35.1, R37.1, SW1.3 (A), SW1.S1 (SHIELD), SW1.S2 (SHIELD), SW1.S3 (SHIELD), SW1.S4 (SHIELD), U1.16 (VSS), U1.31 (VSSA), U1.38 (VSS), U1.51 (VSS), U1.61 (VSS), U1.83 (VSS), U1.94 (VSS), U1.107 (VSS), U1.120 (VSS), U1.130 (VSS), U2.2 (EN_), U2.5 (GND), U2.9 (GND), U3.6 (GND), U3.7 (FSW), U3.8 (DEF), U3.15 (GND), U3.16 (GND), U3.17 (GND), U4.2 (NC), U4.3 (NC), U4.4 (GND), U4.6 (NC), U4.7 (NC), U4.9 (GND), U5.11 (RESV), U5.18 (GND), U5.20 (RESV), U6.9 (GND), U6.11 (GND), U7.3 (VSS), U7.8 (VSS), U7.9 (VSS), U8.3 (GND), Y2.2, Y2.4
GPIO_68: J12.4, U1.68 (PE15)
GPIO_69: J12.5, U1.69 (PB10)
GPIO_70: J13.1, U1.70 (PB11)
GPS_CAN_RX: J8.5, U1.114 (PD0)
GPS_CAN_TX: J8.4, U1.140 (PB9)
GPS_RX: J8.3, R5.2
GPS_TX: J8.2, R6.2
HSE_IN: C18.1, U1.23 (PH0), Y2.1
HSE_OUT: R3.1, U1.24 (PH1)
I2C_SCL: J9.2, R39.1, U1.136 (PB6)
I2C_SDA: J9.3, R38.1, U1.137 (PB7)
IMU_CS: R25.1, U1.22 (PF10), U5.22 (CS)
IMU_INT: U1.15 (PF5), U5.12 (INT1/INT)
IMU_MISO: U1.20 (PF8), U5.9 (SDO/AD0)
IMU_MOSI: U1.21 (PF9), U5.24 (SDA/SDI/SDIO)
IMU_SCK: U1.19 (PF7), U5.23 (SCL/SCLK)
MAG_CS: R26.1, U1.3 (PE4), U6.4 (SPI_CS)
MAG_INT: U1.8 (PC14), U6.15 (INT)
MAG_MISO: U1.4 (PE5), U6.5 (SPI_SDO)
MAG_MOSI: U1.5 (PE6), U6.16 (SDA/SPI_SDI)
MAG_SCK: U1.1 (PE2), U6.1 (SCL/SPI_SCK)
unnamed: C19.1, R3.2, Y2.3
unnamed: C20.1, U1.71 (VCAP)
unnamed: C21.1, U1.106 (VCAP)
unnamed: D1.2 (A), R4.2
unnamed: D4.2 (A), R22.1
unnamed: D5.1 (K), F1.2, J3.A4 (VBUS), J3.B4 (VBUS)
unnamed: D6.2 (A), R33.1
unnamed: J3.A5 (CC1), R34.2
unnamed: J3.B5 (CC2), R35.2
unnamed: Q1.1 (G), R36.1, R37.2
unnamed: R4.1, U1.122 (PD6)
unnamed: R5.1, U1.141 (PE0)
unnamed: R6.1, U1.142 (PE1)
unnamed: R7.2, U1.60 (PE9)
unnamed: R8.2, U1.64 (PE11)
unnamed: R9.2, U1.66 (PE13)
unnamed: R10.2, U1.67 (PE14)
unnamed: R16.2, U2.4 (ILIM)
unnamed: R14.1, R15.2, U2.3 (VSNS)
unnamed: R19.1, R20.2, U3.5 (FB)
unnamed: C29.1, U3.9 (SS/TR)
unnamed: R23.1, U4.5 (EN)
unnamed: C32.2, C33.2, R24.2, TP3.1, U4.1 (OUT)
unnamed: C38.1, U6.10 (CAP)
unnamed: R29.1, U7.5 (SDO)
PO_RX: J10.4, U1.37 (PA3)
PO_SCL: J10.5, R41.1, U1.54 (PF14)
PO_SDA: J10.6, R40.1, U1.55 (PF15)
PO_TX: J10.3, U1.36 (PA2)
PWR_GOOD: R18.1, U1.78 (PD9), U3.4 (PG)
RC_RX: J6.3, U1.97 (PC7)
RC_TX: J6.2, U1.96 (PC6)
RGB_LED_B: R13.1, U1.85 (PD14)
RGB_LED_G: R12.1, U1.82 (PD13)
RGB_LED_R: R11.1, U1.81 (PD12)
SD_CDS: C42.2, J2.10 (CARD_DETECT), R30.1, U1.117 (PD3)
SD_CLK: J2.P5 (CLK), U1.113 (PC12)
SD_CMD: J2.P3 (CMD), U1.116 (PD2)
SD_DAT0: J2.P7 (DAT0), U1.98 (PC8)
SD_DAT1: J2.P8 (DAT1), U1.99 (PC9)
SD_DAT2: J2.P1 (DAT2), U1.111 (PC10)
SD_DAT3: J2.P2 (DAT3/CD), U1.112 (PC11)
SWITCH: J11.5, R42.1, U1.2 (PE3)
TELEM_CTS: J7.4, U1.46 (PB0)
TELEM_RTS: J7.5, U1.75 (PB14)
TELEM_RX: J7.3, U1.35 (PA1)
TELEM_TX: J7.2, U1.34 (PA0)
UART5_RX: J12.2, U1.73 (PB12)
UART5_TX: J12.3, U1.74 (PB13)
USB_D+: J3.A6 (D1+), J3.B6 (D2+), U1.104 (PA12), U8.1 (D+)
USB_D-: J3.A7 (D1-), J3.B7 (D2-), U1.103 (PA11), U8.2 (D-)
USB_VBUS_SENSE: R31.1, R32.2, U1.101 (PA9)
VBUS: C26.2, C43.1, C44.1, F1.1, R31.2, R33.2, TP4.1, U2.6 (IN2)
VREF+_MCU: C16.1, C17.1, R2.2, U1.32 (VREF+)
