Gui-arain/Flight-Controller/firmware/STM32 Cube IDE/FC-proto-El.ioc

Mcu.UserName=STM32H743ZITx
PA0.Signal=UART4_TX
PA1.Signal=UART4_RX
PA11.Signal=USB_OTG_FS_DM
PA12.Signal=USB_OTG_FS_DP
PA4.Signal=GPIO_Output
PA5.Signal=SPI1_SCK
PA6.Signal=ADCx_INP3
PA7.Signal=SPI1_MOSI
PB0.Signal=UART4_CTS
PB10.Signal=SPI2_SCK
PB12.Signal=UART5_RX
PB13.Signal=UART5_TX
PB14.Signal=UART4_RTS
PB5.Signal=FDCAN2_RX
PB6.Signal=FDCAN2_TX
PB7.Signal=I2C1_SDA
PB8.Signal=I2C1_SCL
PC0.Signal=GPXTI0
PC1.Signal=SPI2_MOSI
PC10.Signal=SDMMC1_D2
PC11.Signal=SDMMC1_D3
PC12.Signal=SDMMC1_CK
PC2_C.Signal=SPI2_MISO
PC3_C.Signal=GPIO_Output
PC8.Signal=SDMMC1_D0
PC9.Signal=SDMMC1_D1
PD0.Signal=FDCAN1_RX
PD1.Signal=FDCAN1_TX
PD12.Signal=S_TIM4_CH1
PD13.Signal=S_TIM4_CH2
PD14.Signal=S_TIM4_CH3
PD2.Signal=SDMMC1_CMD
PE11.Signal=S_TIM1_CH2
PE13.Signal=S_TIM1_CH3
PE14.Signal=S_TIM1_CH4
PE9.Signal=S_TIM1_CH1
PF0.Signal=I2C2_SDA
PF1.Signal=I2C2_SCL
PF11.Signal=ADC1_INP2
PF14.Signal=I2C4_SCL
PF15.Signal=I2C4_SDA
PG10.Signal=GPXTI10
PG3.Signal=GPIO_Output
PG5.Signal=GPIO_Input
PG9.Signal=SPI1_MISO
