Gui-arain/Flight-Controller/(commit log)

2025-11-24 first power documention
    [FC-Sensors.kicad_sch, FC-interfaces_sch.kicad_sch, FC-power-section.kicad_sch, FC-proto.kicad_sch]
2025-11-25 Buzzer implementation
    [Component-Library.xlsx, FC-interfaces_sch.kicad_sch, FC-proto.kicad_sch]
2025-11-26 ESC PWM Generation
    [FC-Sensors.kicad_sch, FC-interfaces_sch.kicad_sch, FC-proto.kicad_sch]
