Gui-arain/Flight-Controller/(notices)

Notices in the files:
hardware/cad-layout/FTSH-105-01-F-DV-K/FTSH-105-01-F-DV-K.stp:
author */ ('License CC BY-ND 4.0'),
