Gui-arain/Flight-Controller/exports/imgs/board_testing/Fully_assembled_top_view_defective_board.png

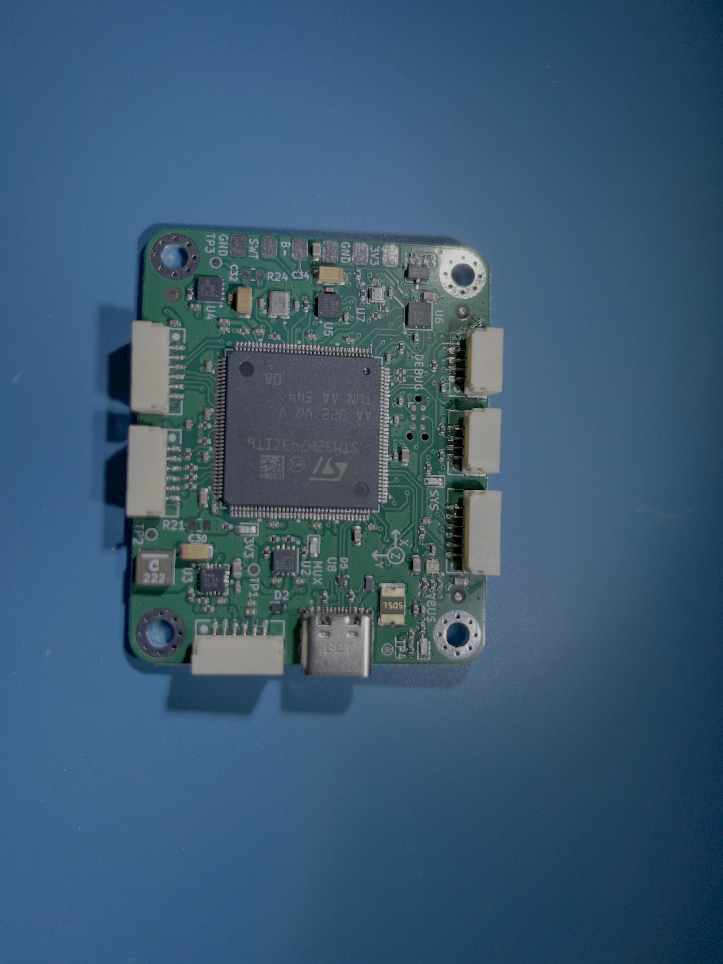
exports/imgs/board_testing/Fully_assembled_top_view_defective_board.png
